zero-emission/Eurorack/4x3Matrix/Module_photo.png

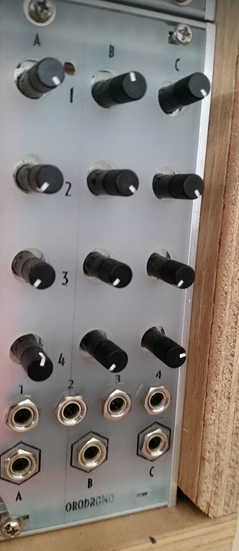
4x3Matrix/Module_photo.png
