zero-emission/Eurorack/README.md

# Eurorack
A collection of open hardware projects for Eurorack
