zero-emission/Eurorack/4x3Matrix/kicad/3x4Matrix_3x072.kicad_pcb

## KiCad design 4x3Matrix/kicad/3x4Matrix_3x072.kicad_pcb (2020-07-19)

Schematic: 3x4Matrix_3x072.sch, 3x4Matrix.sch

Parts:
A_1, A_2, A_3, A_4: A100K; Potentiometer_Alpha_RD901F-40-00D_Single_Vertical
B_1, B_2, B_3, B_4: A100K; Potentiometer_Alpha_RD901F-40-00D_Single_Vertical
C1, C2: 10uF; CP_Radial_D5.0mm_P2.50mm
C3, C4, C5, C6, C7, C8: 100nF; C_0805_2012Metric
C_1, C_2, C_3, C_4: A100K; Potentiometer_Alpha_RD901F-40-00D_Single_Vertical
D1, D2: 1N4004; D_DO-41_SOD81_P10.16mm_Horizontal
IN1, IN2, IN3, IN4: AudioJack; Jack_3.5mm_QingPu_WQP-PJ398SM_Vertical_CircularHoles
OUTA1: AudioJack; Jack_3.5mm_QingPu_WQP-PJ398SM_Vertical_CircularHoles
OUTB1: AudioJack; Jack_3.5mm_QingPu_WQP-PJ398SM_Vertical_CircularHoles
OUTC1: AudioJack; Jack_3.5mm_QingPu_WQP-PJ398SM_Vertical_CircularHoles
R1, R2, R3, R4, R5, R6, R7, R8, R9, R10, R11, R12, R13, R14, R15, R16, R17, R18, R19, R20, R21: 100k; R_0805_2012Metric
R22, R23, R24: 1k; R_0805_2012Metric
SV2: EURO_POWER_HEADERREGULAR; PinHeader_2x05_P2.54mm_Vertical
U1, U2, U3: TL072_SMD; SOIC-8_3.9x4.9mm_P1.27mm

Connections:
/+12UP1: D1.2 (A), SV2.1, SV2.2
/-12UP1: D2.1 (K), SV2.9, SV2.10
/C-11: R3.1, R4.1, R9.2, R18.1, R21.1, U1.2 (-)
/N$1: A_3.2, R1.2
/N$2: B_3.2, R2.2
/N$3: C_3.2, R3.2
/N$4: C_2.2, R4.2
/N$5: B_2.2, R5.2
/N$6: A_2.2, R6.2
/N$7: B_1.2, R8.2
/N$8: C_1.2, R18.2
/N$9: A_1.2, R7.2
/N$10: A_4.3, B_4.3, C_4.3, IN4.T
/N$11: OUTC1.T, R22.1
/N$12: C1.2, C3.2, C5.2, C7.2, D2.2 (A), U1.4 (V-), U2.4 (V-), U3.4 (V-)
/N$13: A_4.2, R19.2
/N$14: B_4.2, R20.2
/N$15: C_4.2, R21.2
/N$16: OUTB1.T, R23.1
/N$17: OUTA1.T, R24.1
/N$18: R1.1, R6.1, R7.1, R15.2, R19.1, U3.2 (-)
/N$21: A_3.3, B_3.3, C_3.3, IN3.T
/N$22: A_2.3, B_2.3, C_2.3, IN2.T
/N$23: A_1.3, B_1.3, C_1.3, IN1.T
/N$24: R12.1, R13.2, U2.1
/N$25: R10.1, R11.2, U1.6 (-)
/N$26: R2.1, R5.1, R8.1, R12.2, R20.1, U2.2 (-)
/N$27: R11.1, R22.2, U1.7
/N$28: R13.1, R14.2, U2.6 (-)
/N$29: R14.1, R23.2, U2.7
/N$32: R16.1, R17.2, U3.6 (-)
/N$33: R17.1, R24.2, U3.7
/N$35: C2.1, C4.1, C6.1, C8.1, D1.1 (K), U1.8 (V+), U2.8 (V+), U3.8 (V+)
/PIN1: R9.1, R10.2, U1.1
/PINN1: R15.1, R16.2, U3.1
GND: A_1.1, A_2.1, A_3.1, A_4.1, B_1.1, B_2.1, B_3.1, B_4.1, C1.1, C2.2, C3.1, C4.2, C5.1, C6.2, C7.1, C8.2, C_1.1, C_2.1, C_3.1, C_4.1, IN1.S, IN2.S, IN3.S, IN4.S, OUTA1.S, OUTB1.S, OUTC1.S, SV2.3, SV2.4, SV2.5, SV2.6, SV2.7, SV2.8, U1.3 (+), U1.5 (+), U2.3 (+), U2.5 (+), U3.3 (+), U3.5 (+)

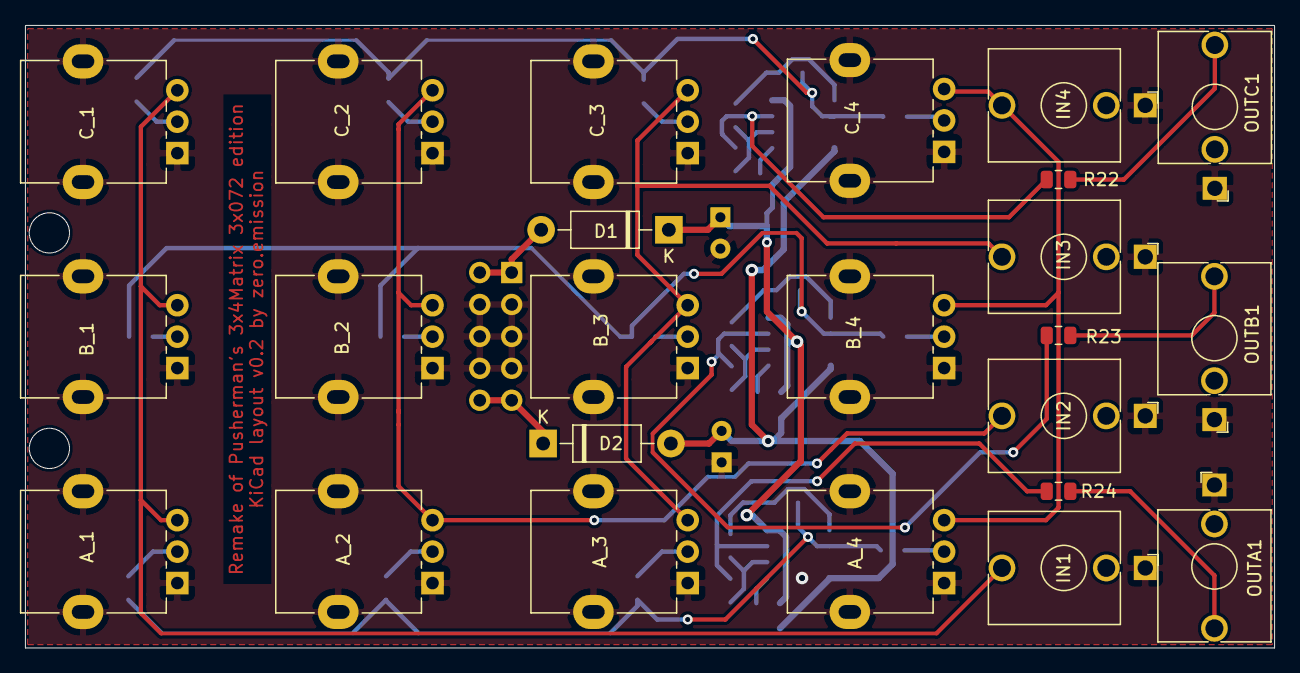
[picture p2: board 3x4Matrix_3x072.kicad_pcb from above]

Board: 2 copper layers, 99.4 x 49.5 mm, 59 parts (0 on the bottom side), 36 nets.

Other parts of the board:
@HOLE0, @HOLE1: (no value)
