zero-emission/Eurorack/4x3Matrix/3x4Matrix.brd

## EAGLE design 4x3Matrix/3x4Matrix.brd (2017-11-08)

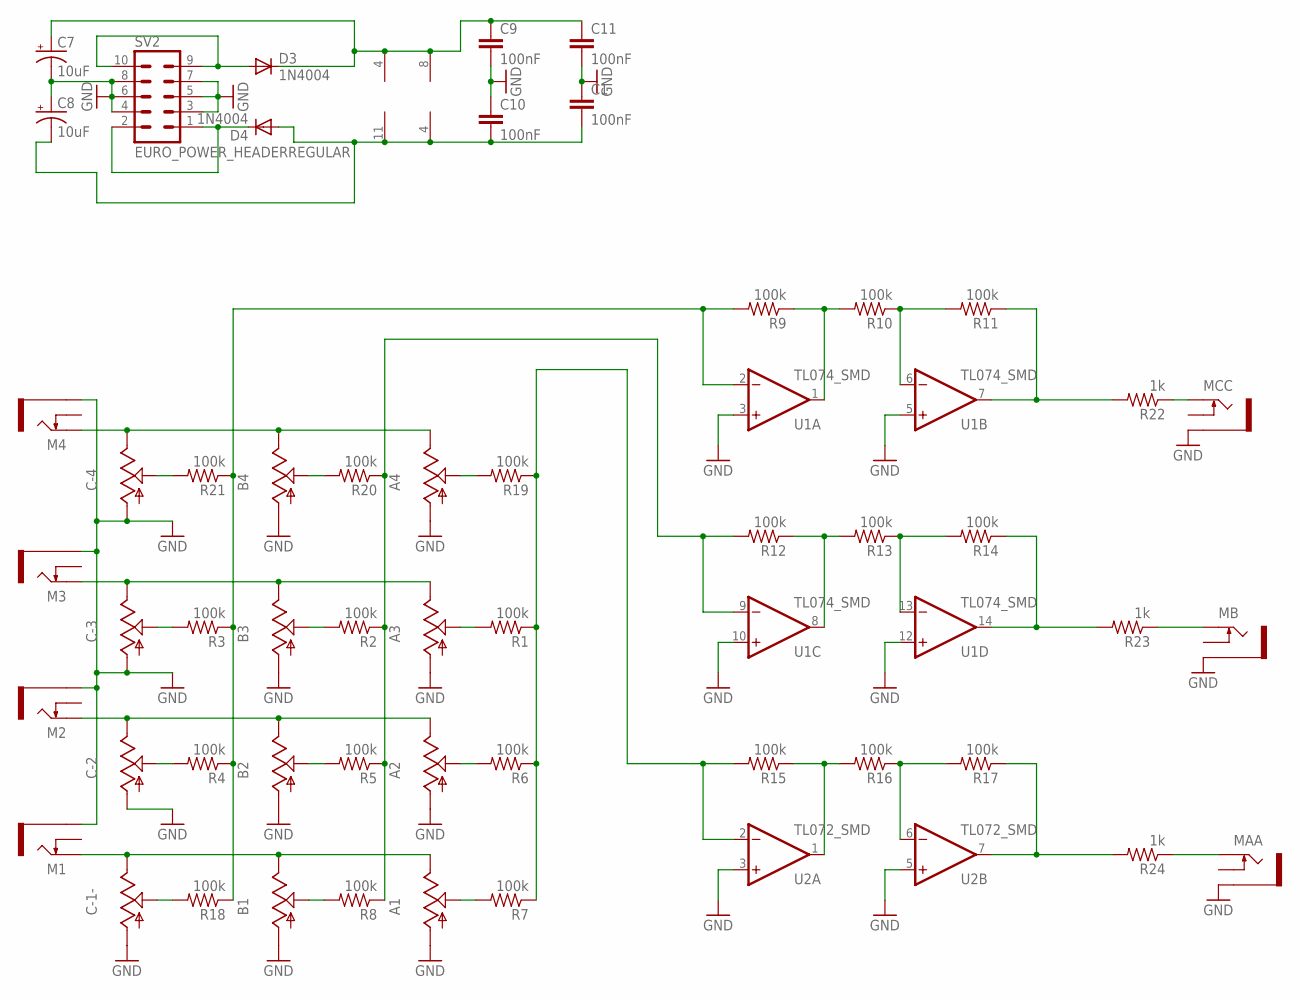
[picture p3: schematic 3x4Matrix.sch]

Parts:
A1, A2, A3, A4: 9MM_SNAP-IN_POT_; 9MM_SNAP-IN_POT
B1, B2, B3, B4: 9MM_SNAP-IN_POT_; 9MM_SNAP-IN_POT
C1, C9, C10, C11: 100nF; 0805
C7, C8: 10uF; CPOL-RADIAL-10UF-25V
C-1-, C-2, C-3, C-4: 9MM_SNAP-IN_POT_; 9MM_SNAP-IN_POT
D3, D4: 1N4004; DO41-10
M1, M2, M3, M4: THONKICONNNEW; WQP-PJ301M-12_JACK
MAA: THONKICONNNEW; WQP-PJ301M-12_JACK
MB: THONKICONNNEW; WQP-PJ301M-12_JACK
MCC: THONKICONNNEW; WQP-PJ301M-12_JACK
R1, R2, R3, R4, R5, R6, R7, R8, R9, R10, R11, R12, R13, R14, R15, R16, R17, R18, R19, R20, R21: 100k; 0805
R22, R23, R24: 1k; 0805
SV2: EURO_POWER_HEADERREGULAR; EURO_POWER_HEADER
U1: TL074_SMD; SO14
U2: TL072_SMD; SO08

Connections:
+12UP1: D3.A, SV2.9, SV2.10
-12UP1: D4.C, SV2.1, SV2.2
C-11: R3.1, R4.1, R9.2, R18.1, R21.1, U1.2 (-IN)
GND: A1.1 (A), A2.1 (A), A3.1 (A), A4.1 (A), B1.1 (A), B2.1 (A), B3.1 (A), B4.1 (A), C1.1, C7.2 (-), C8.1 (+), C9.2, C10.1, C11.2, C-1-.1 (A), C-2.1 (A), C-3.1 (A), C-4.1 (A), M1.P$3_SLEEVE (SLEEVE), M2.P$3_SLEEVE (SLEEVE), M3.P$3_SLEEVE (SLEEVE), M4.P$3_SLEEVE (SLEEVE), MAA.P$3_SLEEVE (SLEEVE), MB.P$3_SLEEVE (SLEEVE), MCC.P$3_SLEEVE (SLEEVE), SV2.3, SV2.4, SV2.5, SV2.6, SV2.7, SV2.8, U1.3 (+IN), U1.5 (+IN), U1.10 (+IN), U1.12 (+IN), U2.3 (+IN), U2.5 (+IN)
unnamed: A3.2 (S), R1.2
unnamed: B3.2 (S), R2.2
unnamed: C-3.2 (S), R3.2
unnamed: C-2.2 (S), R4.2
unnamed: B2.2 (S), R5.2
unnamed: A2.2 (S), R6.2
unnamed: B1.2 (S), R8.2
unnamed: C-1-.2 (S), R18.2
unnamed: A1.2 (S), R7.2
unnamed: A4.3 (E), B4.3 (E), C-4.3 (E), M4.P$1_TIP (TIP)
unnamed: MCC.P$1_TIP (TIP), R22.1
unnamed: C1.2, C8.2 (-), C10.2, D4.A, U1.11 (V-), U2.4 (V-)
unnamed: A4.2 (S), R19.2
unnamed: B4.2 (S), R20.2
unnamed: C-4.2 (S), R21.2
unnamed: MB.P$1_TIP (TIP), R23.1
unnamed: MAA.P$1_TIP (TIP), R24.1
unnamed: R1.1, R6.1, R7.1, R15.2, R19.1, U2.2 (-IN)
unnamed: A3.3 (E), B3.3 (E), C-3.3 (E), M3.P$1_TIP (TIP)
unnamed: A2.3 (E), B2.3 (E), C-2.3 (E), M2.P$1_TIP (TIP)
unnamed: A1.3 (E), B1.3 (E), C-1-.3 (E), M1.P$1_TIP (TIP)
unnamed: R12.1, R13.2, U1.8 (OUT)
unnamed: R10.1, R11.2, U1.6 (-IN)
unnamed: R2.1, R5.1, R8.1, R12.2, R20.1, U1.9 (-IN)
unnamed: R11.1, R22.2, U1.7 (OUT)
unnamed: R13.1, R14.2, U1.13 (-IN)
unnamed: R14.1, R23.2, U1.14 (OUT)
unnamed: R16.1, R17.2, U2.6 (-IN)
unnamed: R17.1, R24.2, U2.7 (OUT)
unnamed: C7.1 (+), C9.1, C11.1, D3.C, U1.4 (V+), U2.8 (V+)
PIN1: R9.1, R10.2, U1.1 (OUT)
PINN1: R15.1, R16.2, U2.1 (OUT)

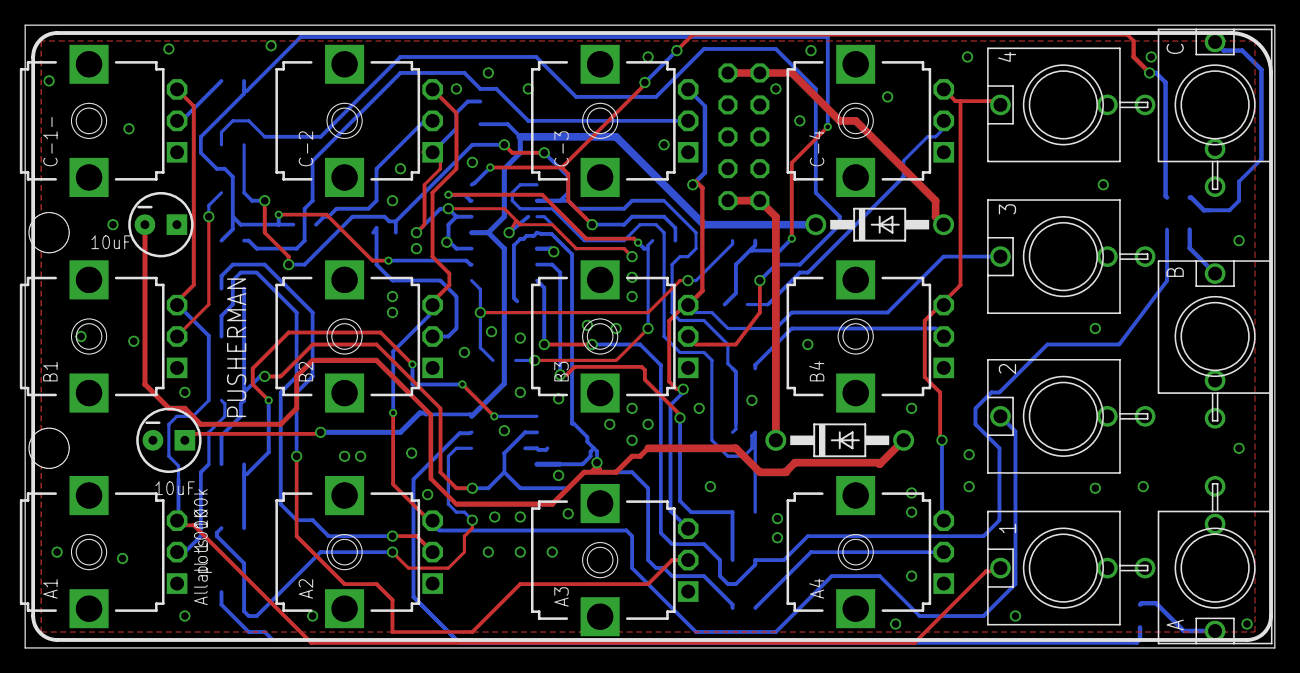
[picture p4: board 3x4Matrix.brd from above]

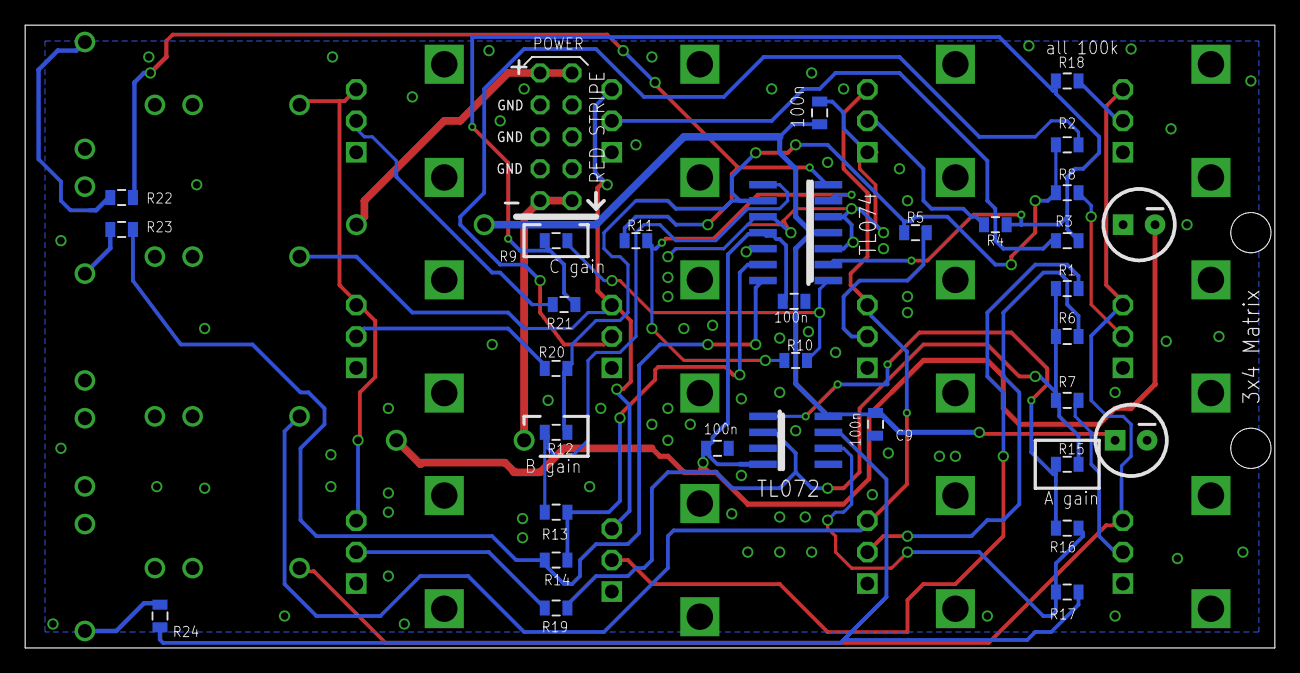
[picture p5: board 3x4Matrix.brd from below]

Board: 2 copper layers, 99.4 x 49.5 mm, 54 parts (31 on the bottom side), 36 nets.
