zero-emission/Eurorack/(commit log)

2017-11-08 Create bom.txt
    Part list
2017-11-08 Add files via upload
    The gerber files
    [3x4Matrix.GBL, 3x4Matrix.GBO, 3x4Matrix.GBP, 3x4Matrix.GBS, 3x4Matrix.GTL, 3x4Matrix.GTO, 3x4Matrix.GTP, 3x4Matrix.GTS]
2017-11-08 Add files via upload
    Eagle files
    [3x4Matrix.brd, 3x4Matrix.sch]
2020-07-05 Conversion of Eagle files to KiCad current version 5.1.6. Work in progress, critical components already replaced by native KiCad library entities.
    [3x4Matrix.kicad_pcb, 3x4Matrix.sch]
2020-07-18 All library parts replaced by default Kicad, new version created which uses 3 TL072 instead of TL072 + TL074 to eliminate crosstalk
    [3x4Matrix.GBL, 3x4Matrix.GBO, 3x4Matrix.GBP, 3x4Matrix.GBS, 3x4Matrix.GTL, 3x4Matrix.GTO, 3x4Matrix.GTP, 3x4Matrix.GTS]
2020-07-19 Corrections made to ground planes, trace widths, etc. after visual checks of printout
    [3x4Matrix_3x072.kicad_pcb, 3x4Matrix_3x072.sch]
